yosshipaopao/PRC2025/LBR-127HLD-1.1.0/README.md

# LBR-127HLD library for KiCad

This is a library just add Letex Technology Corp's LBR-127HLB sensor for KiCad.

## Install

First, download a zip file of this repository or clone this repository locally.

Library data is in `LBR-127HLD Libraries/`.

And then, open your KiCad project, add symbol library (`LBR-127.kicad_sym`) and footprint library (`LBR-127HLD.pretty/`).

---

# KiCad用LBR-127HLDライブラリ

Letex Technology社のLBR-127HLDのKiCad用ライブラリです。

## インストール

このリポジトリのzipファイルをダウンロードするか、このリポジトリをローカルにクローンするかしてください。

ライブラリのデータは`LBR-127HLD Libraries/`の中にあります。

KiCadのプロジェクトを開き、シンボルライブラリ(`LBR-127.kicad_sym`)とフットプリント(`LBR-127HLD.pretty/`)を追加してください。

---

## License

MIT
