yosshipaopao/PRC2025/program/SAFETY_IMPROVEMENTS.md

# メモリ安全性と実行時エラーの改善

## 実施した変更

### 1. **メモリ安全性の改善**

#### MotorPowerAverager クラス
- ✅ インデックス計算の修正：`(index - 1 - i + buffer_size * 2) % buffer_size` で負の値を確実に防止
- ✅ ゼロ除算防止：`weight_sum == 0` のチェックを追加
- ✅ オーバーフロー防止：`(long)` キャストを使用して乗算時のオーバーフロー防止
- ✅ 入力値の範囲制約：`addPower()` と `forceSet()` で -255～255 の範囲に制約
- ✅ バッファサイズチェック：コンストラクタで不正なサイズを修正
- ✅ インデックスリセット：`forceSet()` でインデックスをゼロにリセット
- ✅ nullptr セット：デストラクタでポインタをnullptrに設定
- ✅ コピー禁止：コピーコンストラクタとコピー代入演算子を削除
- ✅ nullptr チェック：`addPower()` と `forceSet()` でバッファの初期化を確認

#### Sensor クラス
- ✅ 入力チェック：コンストラクタで `pin_array == nullptr` と `pin_count <= 0` をチェック
- ✅ 配列外参照防止：`get()` メソッドで範囲チェック済み
- ✅ nullptr セット：デストラクタでポインタをnullptrに設定
- ✅ コピー禁止：コピーコンストラクタとコピー代入演算子を削除
- ✅ 初期化順序：メンバ変数の初期化順序を修正
- ✅ nullptr チェック：`begin()`, `read()`, `state()` でバッファの初期化を確認

#### StateManager クラス
- ✅ 入力チェック：`setStateMap()` で `map == nullptr` と `size <= 0` をチェック
- ✅ nullptr セット：削除後にポインタをnullptrに設定
- ✅ コピー禁止：コピーコンストラクタとコピー代入演算子を削除
- ✅ ダブルデリート防止：デストラクタでnullptrチェック後に削除

#### TimeoutManager クラス
- ✅ 配列外参照防止：すべてのメソッドで `id < 0 || id >= MAX_TIMEOUTS` をチェック済み
- ✅ オーバーフロー対応：`(long)` キャストで時刻の差分を計算

#### Motor クラス
- ✅ 範囲制約：`run()` メソッドで速度を -255～255 に制約

### 2. **実行時エラー対策**

#### ウォッチドッグタイムアウト防止
- ✅ `delay(2000)` をyield()を含むループに変更
  - C字折り返し検出時の2秒旋回
  - 行き止まり検出時の2秒旋回
- ✅ メインループの待機処理にyield()を追加
- ✅ 50msごとにyield()と_run_motor()を呼び出し、モーター制御を継続

#### カウンタオーバーフロー防止
- ✅ `state_count` の上限を30000に設定
- ✅ 長時間同じ状態が続いてもintがオーバーフローしない

#### タイミング同期の改善
- ✅ `time_diff` の範囲チェックを改善
- ✅ 100ms以上の遅延だけでなく、-1000ms以上進んでいる場合もリセット
- ✅ オーバーフロー時の異常な時刻差に対応

#### 初期化の確認
- ✅ setup()で初期化完了をLED点滅で通知（3回点滅）
- ✅ デバッグメッセージでメインループ開始を通知

### 3. **エッジケースの処理**

- ✅ センサー値が不正な場合のデフォルト値（0）返却
- ✅ 状態マップにない状態の場合の前状態維持
- ✅ タイムアウトIDの範囲外アクセス時の安全なリターン
- ✅ バッファが未初期化の場合の早期リターン

## 安全性の保証

### メモリリーク防止
- すべてのクラスで適切なデストラクタを実装
- `new[]` で確保したメモリは `delete[]` で解放
- 削除後は必ずnullptrを設定

### 配列外参照防止
- すべての配列アクセスで範囲チェックを実施
- インデックス計算では必ず正の値になるよう調整

### ダブルデリート防止
- コピーコンストラクタとコピー代入演算子を削除
- nullptr チェック後に削除を実行

### オーバーフロー防止
- 大きな値の乗算前に `long` キャストを実施
- 時刻計算では差分を使用してオーバーフロー対応
- カウンタに上限を設定

### ゼロ除算防止
- 除算前に分母がゼロでないことを確認

### 不正な入力値の防止
- コンストラクタとセッターで入力値を検証
- 不正な値の場合は早期リターンまたはデフォルト値を使用

### ウォッチドッグタイムアウト防止
- 長時間のdelay()を分割してyield()を定期的に呼び出し
- ループ内でyield()を呼び出してタスクスイッチを許可

これらの変更により、ESP32での長時間稼働でもメモリエラーや実行時エラーが発生しにくくなりました。
