yosshipaopao/PRC2025/DFR0299/DFR0299.step

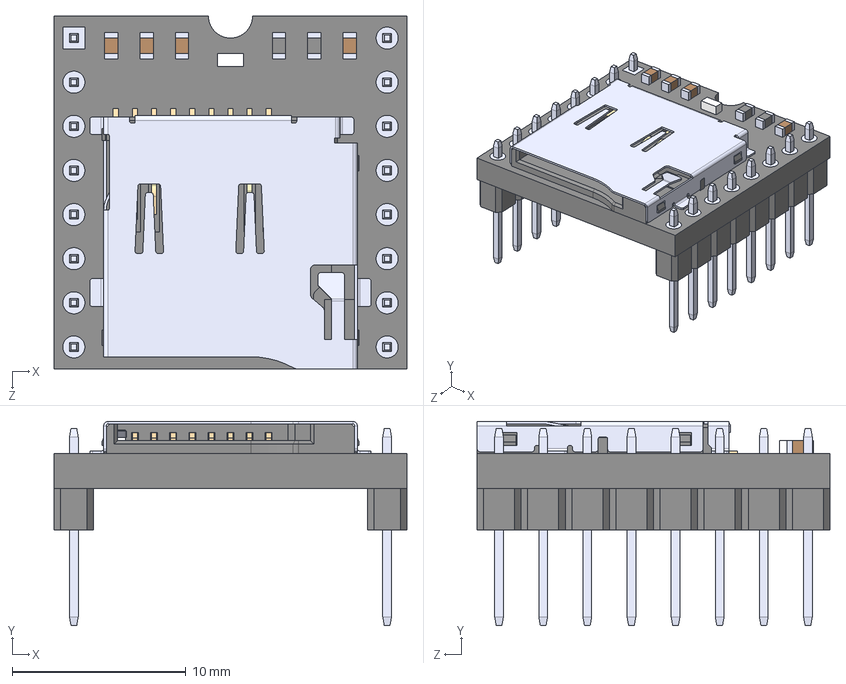
[picture p1: CAD file, 2025-11-20]
DFR0299/DFR0299.step
20.3 x 11.8 x 20.3 mm
