yosshipaopao/PRC2025/button/button.kicad_pcb

## KiCad design button/button.kicad_pcb (2026-02-06)

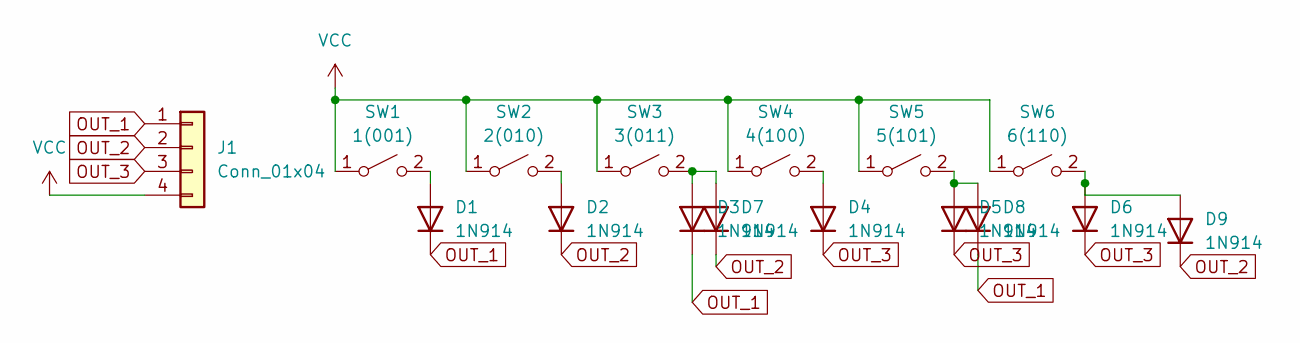
[picture p2: schematic button.kicad_sch]

Parts:
D1, D2, D3, D4, D5, D6, D7, D8, D9: 1N914; D_SOD-523
J1: Conn_01x04; PinSocket_1x04_P2.54mm_Vertical
SW1: 1(001); SW_PUSH_6mm
SW2: 2(010); SW_PUSH_6mm
SW3: 3(011); SW_PUSH_6mm
SW4: 4(100); SW_PUSH_6mm
SW5: 5(101); SW_PUSH_6mm
SW6: 6(110); SW_PUSH_6mm

Connections:
unnamed: D1.2 (A), SW1.2 (B)
unnamed: D2.2 (A), SW2.2 (B)
unnamed: D3.2 (A), D7.2 (A), SW3.2 (B)
unnamed: D4.2 (A), SW4.2 (B)
unnamed: D5.2 (A), D8.2 (A), SW5.2 (B)
unnamed: D6.2 (A), D9.2 (A), SW6.2 (B)
OUT_1: D1.1 (K), D3.1 (K), D8.1 (K), J1.1
OUT_2: D2.1 (K), D7.1 (K), D9.1 (K), J1.2
OUT_3: D4.1 (K), D5.1 (K), D6.1 (K), J1.3
VCC: J1.4, SW1.1 (A), SW2.1 (A), SW3.1 (A), SW4.1 (A), SW5.1 (A), SW6.1 (A)

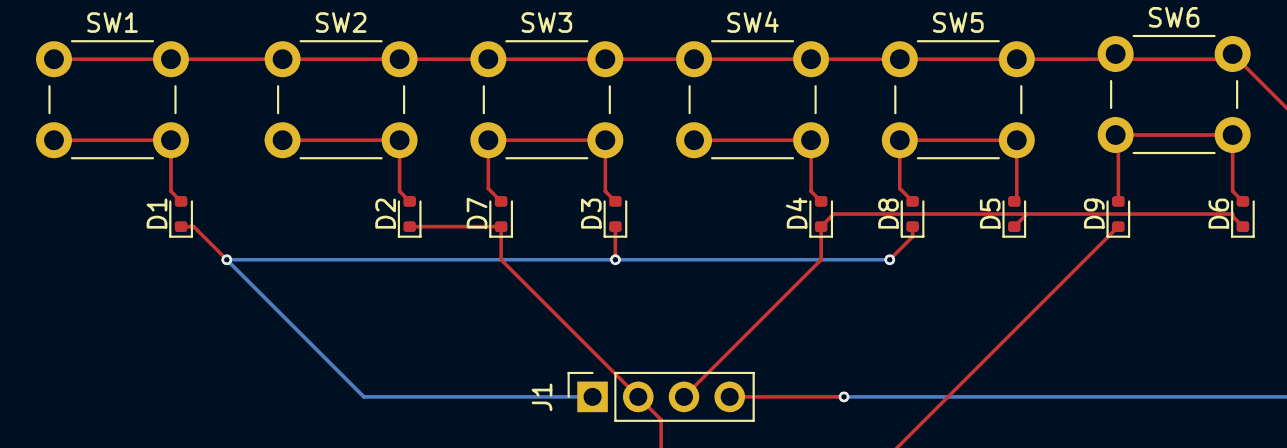
[picture p3: board button.kicad_pcb from above]

Board: 2 copper layers, 16 parts (0 on the bottom side), 10 nets.
