yosshipaopao/PRC2025/Fires/Fires.kicad_pcb

## KiCad design Fires/Fires.kicad_pcb (2025-12-10)

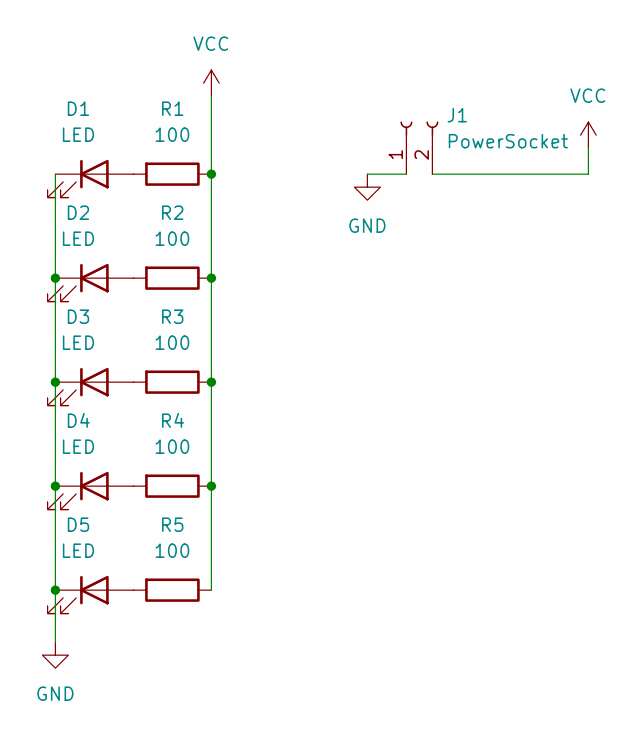
[picture p4: schematic Fires.kicad_sch]

Parts:
D1, D2, D3, D4, D5: LED; LED_D3.0mm
J1: PowerSocket; PinSocket_1x02_P2.54mm_Vertical
R1, R2, R3, R4, R5: 100; R_0603_1608Metric

Connections:
GND: D1.1 (K), D2.1 (K), D3.1 (K), D4.1 (K), D5.1 (K), J1.1
unnamed: D1.2 (A), R1.2
unnamed: D2.2 (A), R2.2
unnamed: D3.2 (A), R3.2
unnamed: D4.2 (A), R4.2
unnamed: D5.2 (A), R5.2
VCC: J1.2, R1.1, R2.1, R3.1, R4.1, R5.1

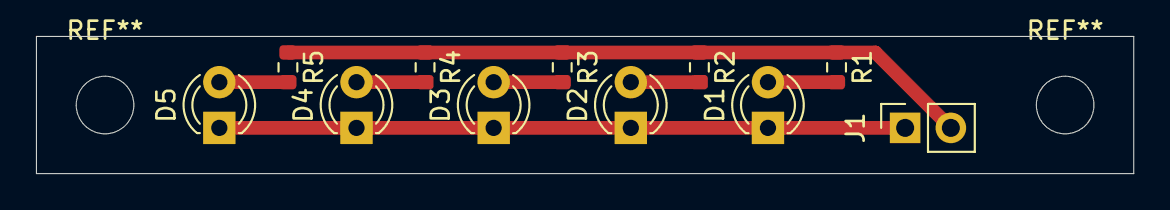
[picture p5: board Fires.kicad_pcb from above]

Board: 2 copper layers, 61.0 x 7.6 mm, 11 parts (0 on the bottom side), 7 nets.
