yosshipaopao/PRC2025/Main/Main.kicad_pcb

## KiCad design Main/Main.kicad_pcb (2025-12-10)

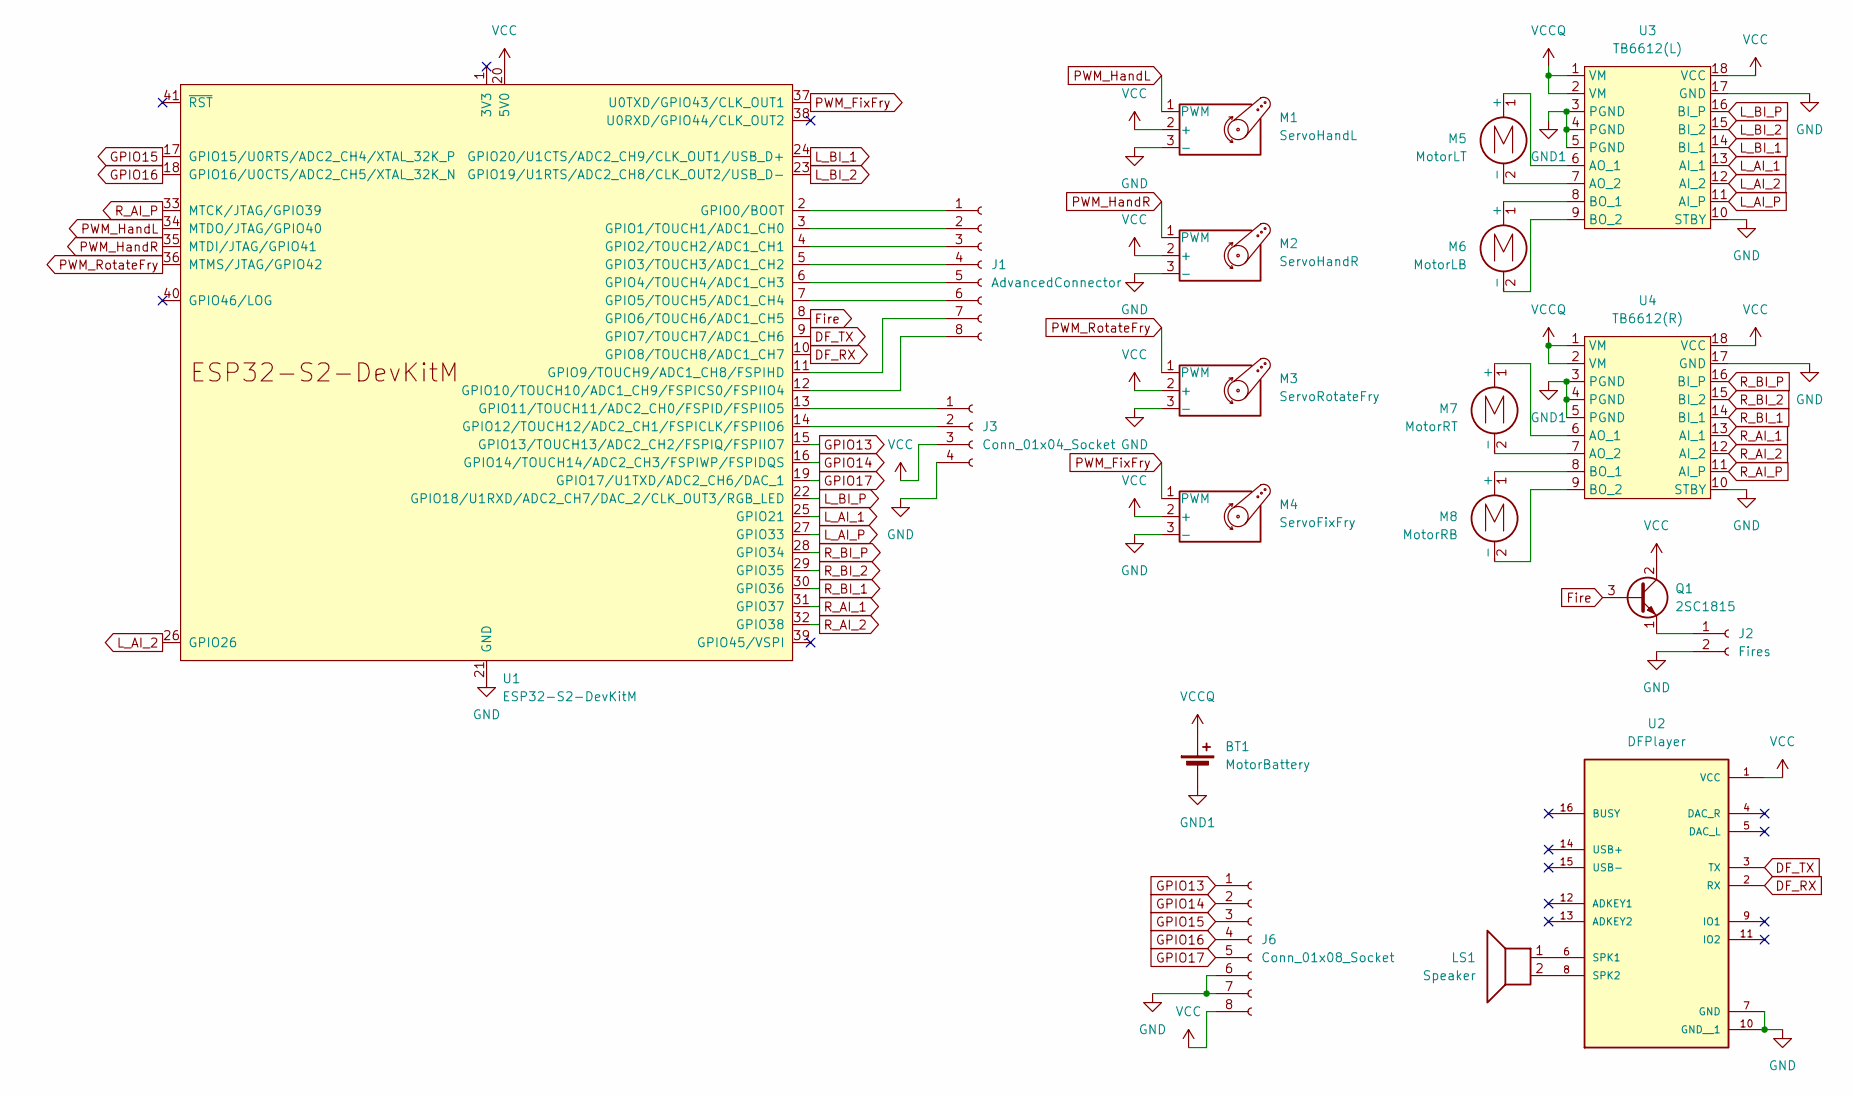
[picture p6: schematic Main.kicad_sch]

Parts:
BT1: MotorBattery; PinSocket_1x02_P2.54mm_Vertical
J1: AdvancedConnector; PinSocket_1x08_P2.54mm_Vertical
J2: Fires; PinSocket_1x02_P2.54mm_Vertical
J3: Conn_01x04_Socket; PinSocket_1x04_P2.54mm_Vertical
J6: Conn_01x08_Socket; PinSocket_1x08_P2.54mm_Vertical
LS1: Speaker; PinSocket_1x02_P2.54mm_Vertical
M1: ServoHandL; PinHeader_1x03_P2.54mm_Vertical
M2: ServoHandR; PinHeader_1x03_P2.54mm_Vertical
M3: ServoRotateFry; PinHeader_1x03_P2.54mm_Vertical
M4: ServoFixFry; PinHeader_1x03_P2.54mm_Vertical
M5: MotorLT; PinSocket_1x02_P2.54mm_Vertical
M6: MotorLB; PinSocket_1x02_P2.54mm_Vertical
M7: MotorRT; PinSocket_1x02_P2.54mm_Vertical
M8: MotorRB; PinSocket_1x02_P2.54mm_Vertical
Q1: 2SC1815; TO-92_Inline
U1: ESP32-S2-DevKitM
U2: DFPlayer; MODULE_DFR0299
U3: TB6612(L); TB6612
U4: TB6612(R); TB6612

Connections:
DF_RX: U1.10 (GPIO8/TOUCH8/ADC1_CH7), U2.2 (RX)
DF_TX: U1.9 (GPIO7/TOUCH7/ADC1_CH6), U2.3 (TX)
Fire: Q1.3 (B), U1.8 (GPIO6/TOUCH6/ADC1_CH5)
GND: J2.2, J3.4, J6.6, J6.7, M1.3 (-), M2.3 (-), M3.3 (-), M4.3 (-), U1.21 (GND), U1.42 (GND), U2.7 (GND), U2.10 (GND__1), U3.10 (STBY), U3.17 (GND), U4.10 (STBY), U4.17 (GND)
GND1: BT1.2 (-), U3.3 (PGND), U3.4 (PGND), U3.5 (PGND), U4.3 (PGND), U4.4 (PGND), U4.5 (PGND)
GPIO13: J6.1, U1.15 (GPIO13/TOUCH13/ADC2_CH2/FSPIQ/FSPIIO7)
GPIO14: J6.2, U1.16 (GPIO14/TOUCH14/ADC2_CH3/FSPIWP/FSPIDQS)
GPIO15: J6.3, U1.17 (GPIO15/U0RTS/ADC2_CH4/XTAL_32K_P)
GPIO16: J6.4, U1.18 (GPIO16/U0CTS/ADC2_CH5/XTAL_32K_N)
GPIO17: J6.5, U1.19 (GPIO17/U1TXD/ADC2_CH6/DAC_1)
L_AI_1: U1.25 (GPIO21), U3.13 (AI_1)
L_AI_2: U1.26 (GPIO26), U3.12 (AI_2)
L_AI_P: U1.27 (GPIO33), U3.11 (AI_P)
L_BI_1: U1.24 (GPIO20/U1CTS/ADC2_CH9/CLK_OUT1/USB_D+), U3.14 (BI_1)
L_BI_2: U1.23 (GPIO19/U1RTS/ADC2_CH8/CLK_OUT2/USB_D-), U3.15 (BI_2)
L_BI_P: U1.22 (GPIO18/U1RXD/ADC2_CH7/DAC_2/CLK_OUT3/RG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), U3.16 (BI_P)
unnamed: J1.1, U1.2 (GPIO0/BOOT)
unnamed: J1.2, U1.3 (GPIO1/TOUCH1/ADC1_CH0)
unnamed: J1.3, U1.4 (GPIO2/TOUCH2/ADC1_CH1)
unnamed: J1.4, U1.5 (GPIO3/TOUCH3/ADC1_CH2)
unnamed: J1.5, U1.6 (GPIO4/TOUCH4/ADC1_CH3)
unnamed: J1.6, U1.7 (GPIO5/TOUCH5/ADC1_CH4)
unnamed: J1.7, U1.11 (GPIO9/TOUCH9/ADC1_CH8/FSPIHD)
unnamed: J1.8, U1.12 (GPIO10/TOUCH10/ADC1_CH9/FSPICS0/FSPIIO4)
unnamed: J2.1, Q1.1 (E)
unnamed: J3.1, U1.13 (GPIO11/TOUCH11/ADC2_CH0/FSPID/FSPIIO5)
unnamed: J3.2, U1.14 (GPIO12/TOUCH12/ADC2_CH1/FSPICLK/FSPIIO6)
unnamed: M5.1 (+), U3.6 (AO_1)
unnamed: M5.2 (-), U3.7 (AO_2)
unnamed: M6.1 (+), U3.8 (BO_1)
unnamed: M6.2 (-), U3.9 (BO_2)
unnamed: M7.1 (+), U4.6 (AO_1)
unnamed: M7.2 (-), U4.7 (AO_2)
unnamed: M8.1 (+), U4.8 (BO_1)
unnamed: M8.2 (-), U4.9 (BO_2)
unnamed: LS1.1, U2.6 (SPK1)
unnamed: LS1.2, U2.8 (SPK2)
PWM_FixFry: M4.1 (PWM), U1.37 (U0TXD/GPIO43/CLK_OUT1)
PWM_HandL: M1.1 (PWM), U1.34 (MTDO/JTAG/GPIO40)
PWM_HandR: M2.1 (PWM), U1.35 (MTDI/JTAG/GPIO41)
PWM_RotateFry: M3.1 (PWM), U1.36 (MTMS/JTAG/GPIO42)
R_AI_1: U1.31 (GPIO37), U4.13 (AI_1)
R_AI_2: U1.32 (GPIO38), U4.12 (AI_2)
R_AI_P: U1.33 (MTCK/JTAG/GPIO39), U4.11 (AI_P)
R_BI_1: U1.30 (GPIO36), U4.14 (BI_1)
R_BI_2: U1.29 (GPIO35), U4.15 (BI_2)
R_BI_P: U1.28 (GPIO34), U4.16 (BI_P)
VCC: J3.3, J6.8, M1.2 (+), M2.2 (+), M3.2 (+), M4.2 (+), Q1.2 (C), U1.20 (5V0), U2.1 (VCC), U3.18 (VCC), U4.18 (VCC)
VCCQ: BT1.1 (+), U3.1 (VM), U3.2 (VM), U4.1 (VM), U4.2 (VM)

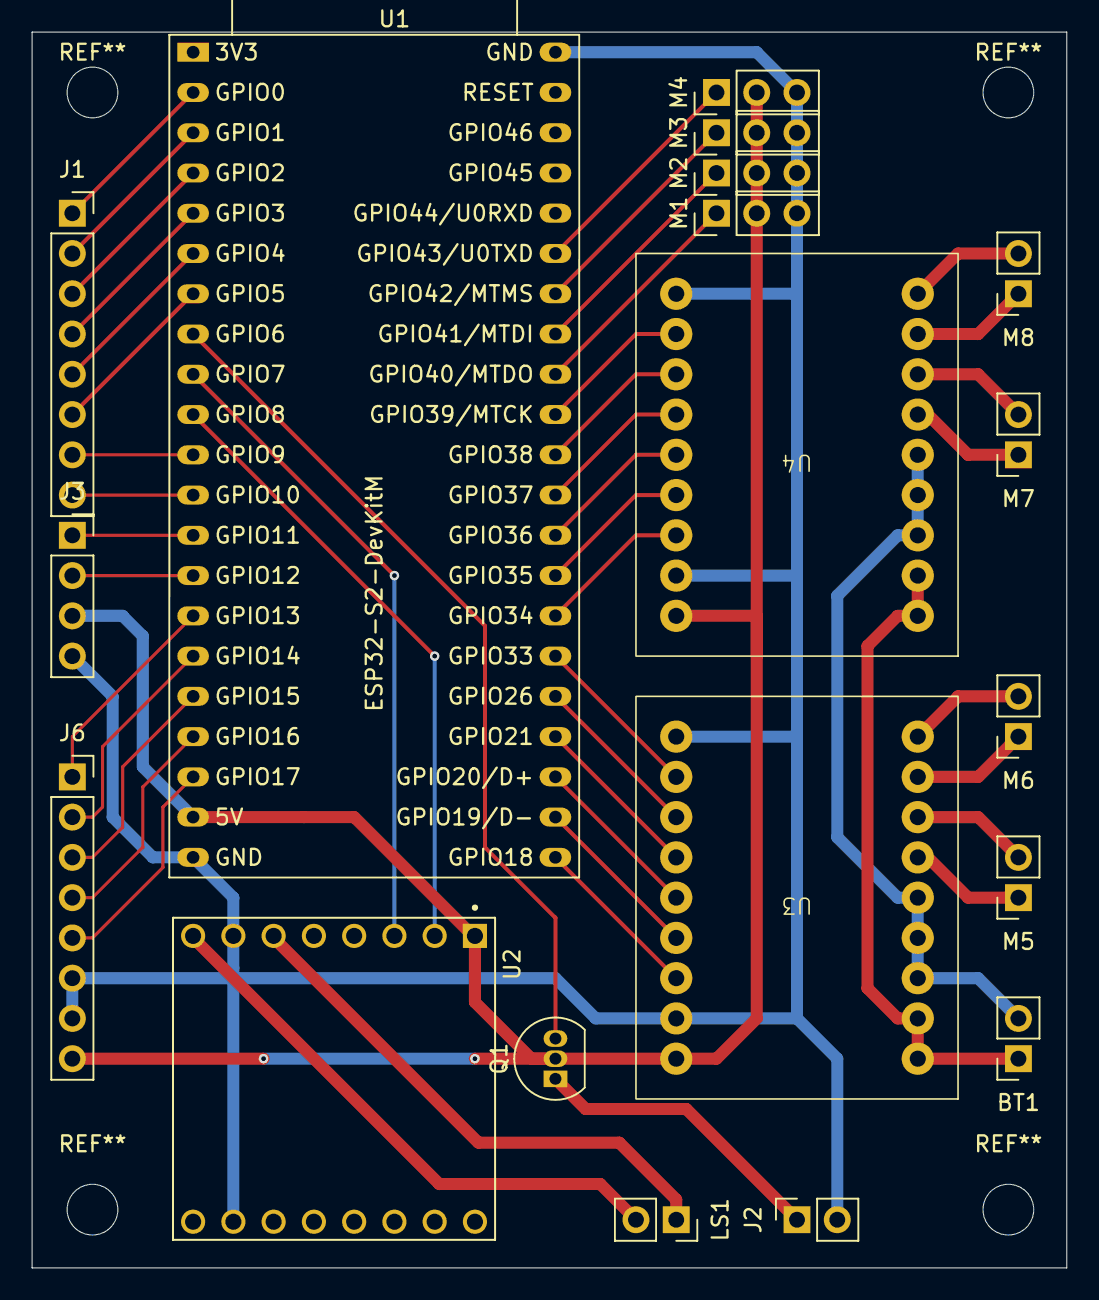
[picture p7: board Main.kicad_pcb from above]

Board: 2 copper layers, 65.3 x 78.0 mm, 19 parts (0 on the bottom side), 49 nets.
