yosshipaopao/PRC2025/Sensor/Sensor.kicad_pcb

## KiCad design Sensor/Sensor.kicad_pcb (2025-12-10)

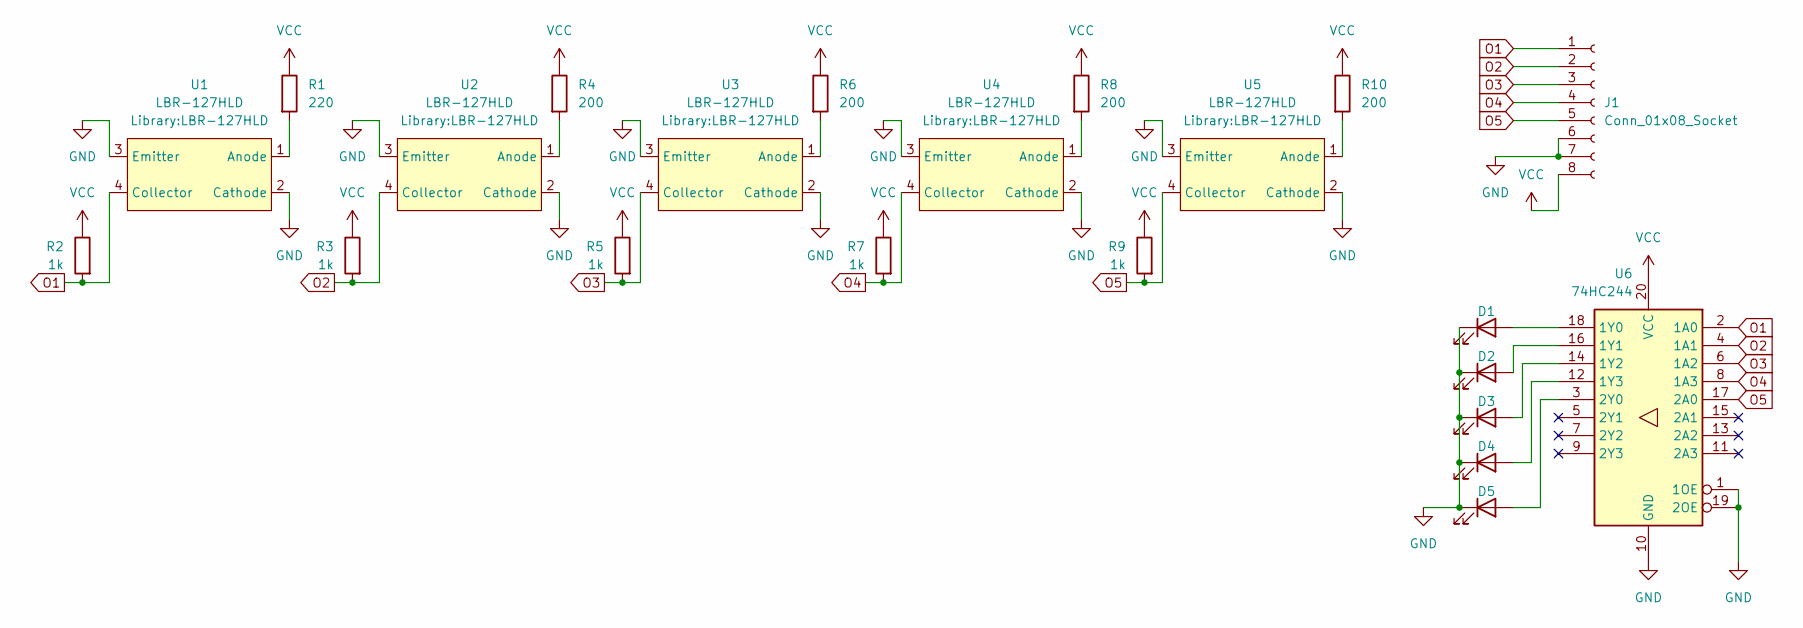
[picture p8: schematic Sensor.kicad_sch]

Parts:
D1, D2, D3, D4, D5: LED; LED_0603_1608Metric
J1: Conn_01x08_Socket; PinSocket_1x08_P2.54mm_Vertical
R1: 220; R_0603_1608Metric
R2, R3, R5, R7, R9: 1k; R_0603_1608Metric
R4, R6, R8, R10: 200; R_0603_1608Metric
U1, U2, U3, U4, U5: LBR-127HLD
U6: 74HC244; SSOP-20_4.4x6.5mm_P0.65mm

Connections:
GND: D1.1 (K), D2.1 (K), D3.1 (K), D4.1 (K), D5.1 (K), J1.6, J1.7, U1.2 (Cathode), U1.3 (Emitter), U2.2 (Cathode), U2.3 (Emitter), U3.2 (Cathode), U3.3 (Emitter), U4.2 (Cathode), U4.3 (Emitter), U5.2 (Cathode), U5.3 (Emitter), U6.1 (1OE), U6.10 (GND), U6.19 (2OE)
unnamed: D1.2 (A), U6.18 (1Y0)
unnamed: D2.2 (A), U6.16 (1Y1)
unnamed: D3.2 (A), U6.14 (1Y2)
unnamed: D4.2 (A), U6.12 (1Y3)
unnamed: D5.2 (A), U6.3 (2Y0)
unnamed: R1.2, U1.1 (Anode)
unnamed: R4.2, U2.1 (Anode)
unnamed: R6.2, U3.1 (Anode)
unnamed: R8.2, U4.1 (Anode)
unnamed: R10.2, U5.1 (Anode)
O1: J1.1, R2.2, U1.4 (Collector), U6.2 (1A0)
O2: J1.2, R3.2, U2.4 (Collector), U6.4 (1A1)
O3: J1.3, R5.2, U3.4 (Collector), U6.6 (1A2)
O4: J1.4, R7.2, U4.4 (Collector), U6.8 (1A3)
O5: J1.5, R9.2, U5.4 (Collector), U6.17 (2A0)
VCC: J1.8, R1.1, R2.1, R3.1, R4.1, R5.1, R6.1, R7.1, R8.1, R9.1, R10.1, U6.20 (VCC)

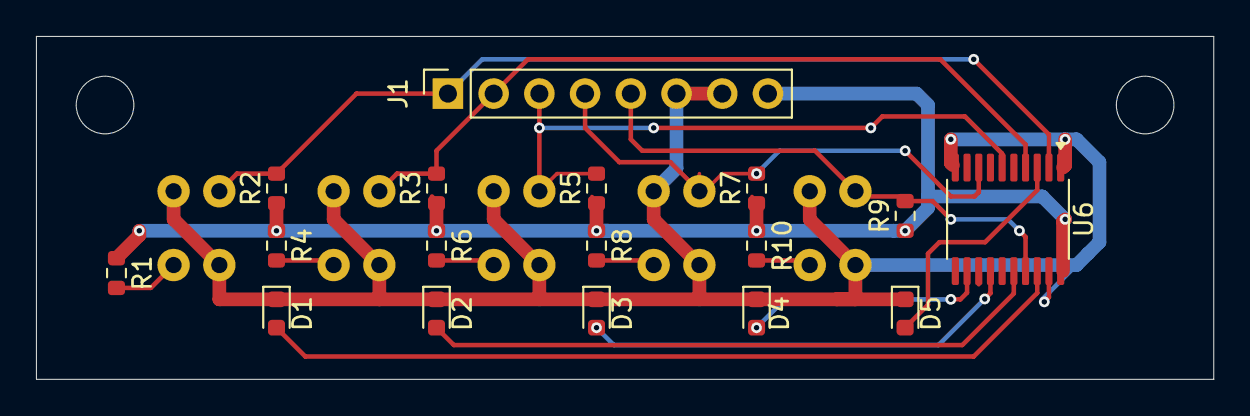
[picture p9: board Sensor.kicad_pcb from above]

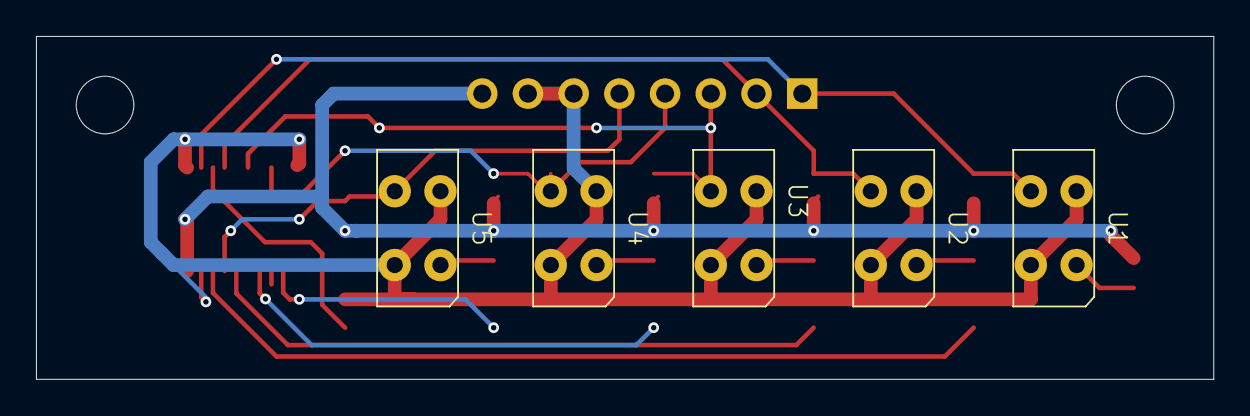
[picture p10: board Sensor.kicad_pcb from below]

Board: 2 copper layers, 65.4 x 19.0 mm, 22 parts (5 on the bottom side), 17 nets.
