yosshipaopao/PRC2025/(commit log)

2025-11-19 add fires and sensor
    [Fires.kicad_pcb, Fires.kicad_sch, LBR-127HLD.kicad_pcb, LBR-127HLD.kicad_sch, Sensor.kicad_pcb, Sensor.kicad_sch]
2025-11-20 main cir
    [DFR0299.step, Main.kicad_pcb, Main.kicad_sch]
2025-11-22 up main
    [Main.kicad_pcb, Main.kicad_sch]
2025-12-10 センサー関係忘れてた
    [Main.kicad_pcb, Main.kicad_sch, Sensor.kicad_pcb, Sensor.kicad_sch]
2025-12-10 kicadで開きながらコミットしちゃダメって言ったでしょ！
2025-12-10 出力を追加
    [Fires.kicad_pcb, Fires.kicad_sch, Main.kicad_pcb, Main.kicad_sch, Sensor.kicad_pcb, Sensor.kicad_sch, bom.csv, designators.csv]
